clydemcqueen/pressure_logger/(commit log)

2026-03-28 First test
    [2026_03_26.csv]
2026-03-28 Day 2
    [2026_03_27.csv]
2026-03-30 Day 3
    [2026_03_28.csv]
